Luddi96/BREmote-V2/Electronics/github_public/Rx/Rx_Nano/Rx_Nano_V2-1_BOM.xlsx

Comment | Designator | Footprint | JLCPCB Part #（optional）
1M | R22 | R0402
1N4148WS | D2,D5 | SODFL2512X90N | C2128
1k | R3,R38,R42 | R0402
1u | C5,C6,C12 | C0603
2.2uF | C11 | C0603
3k3 | R12 | R0402
5k1 | R5,R6 | R0402
LQW15AN6N8G00D | L_ANT1 | R0402 | C82919
10k | R4,R10,R11,R15,R20,R24,R28 | R0402
74HC4052PW 118 | IC6 | SOP65P640X110-16N | C19723807
100n | C1,C2,C4,C7,C8,C9,C10,C13,C16 | C0402
120k | R1 | R0603
AMS1117-3.3 | IC2 | SOT229P700X180-4N | C6186
AO3400A | Q3,Q4 | SOT95P280X125-3N | C20917
AW9523BTQR | IC1 | QFN50P400X400X80-25N | C148077
CH340K | AC1 | SOP100P600X180-11N | C968586
EL3H7_TA_-VG | IC4 | SOIC127P700X200-4N | C32565
MMBT5551 | T1 | SOT23-BEC | C2145
KT-0603R | LED3 | CHIP-LED0603 | C2286
P6SMB6.8CA | D4 | DIONM5436X261N | C78395
RFANT3216120A5T | R2 | R1206 | C127629
SM04B-SRSS-TB_LF__SN__P_ | J5 | SM04BSRSSTBLFSNP | C51940130 | alt C160404
SM06B-GHS-GB-TB_LF__SN_ | J2 | SM06BGHSGBTBLFSN | C51940119 | alt C51940119
SN74LV1T08DBVR(UMW) | IC7,IC8,IC9,IC10 | SOT-23-5 | C19100599
TYPE-C-31-M-12 | J1 | HRO_TYPE-C-31-M-12 | C165948
