Luddi96/BREmote-V2/Electronics/github_public/Rx/Rx_Nano/Rx_Nano_V2-1.pdf

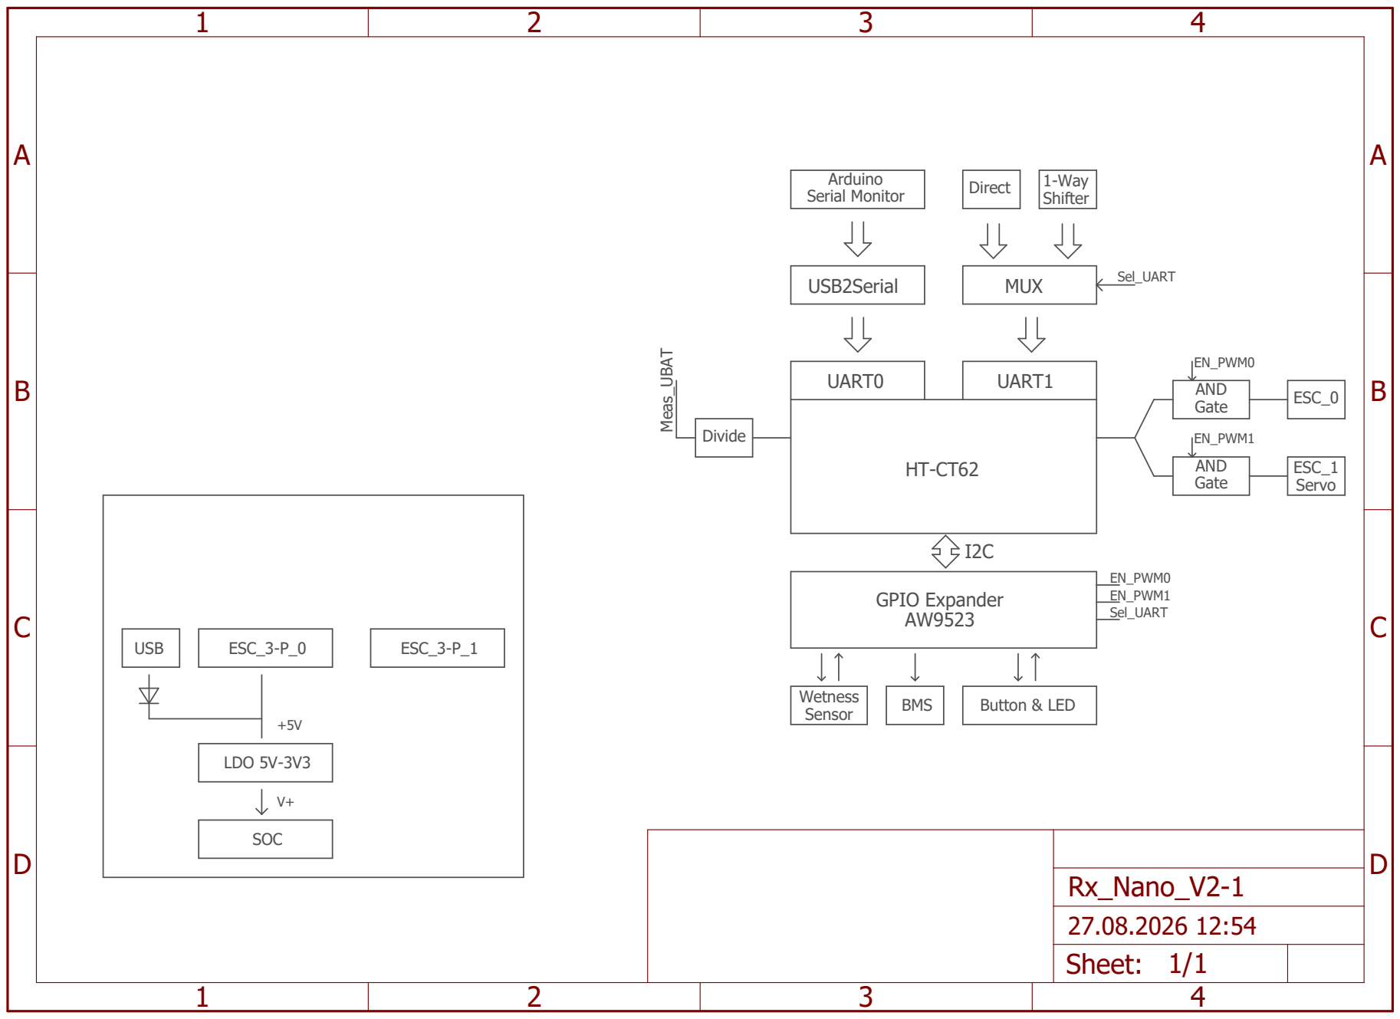
[picture p4: figure]
UART0; UART1; USB2Serial; MUX; Direct Arduino; Serial Monitor; 1-Way; Shifter; AND Gate; ESC_0; ESC_1 Servo; EN_PWM0; EN_PWM1; Sel_UART; Divide Meas_UBAT; GPIO Expander AW9523; Wetness; Sensor; BMS; Button & LED; EN_PWM0 EN_PWM1 Sel_UART; ESC_3-P_0; LDO 5V-3V3; ESC_3-P_1; SOC; USB; Sheet:; Rx_Nano_V2-1 27.08.2026 12:54 1/1

27.08.2026 12:55 f=1.45 C:\Users\rcb8fe\Desktop\Rx_Nano\Rx_Nano_V2-1.sch (Sheet: 1/1)

# V+ ⁺⁵V

# 1k GND

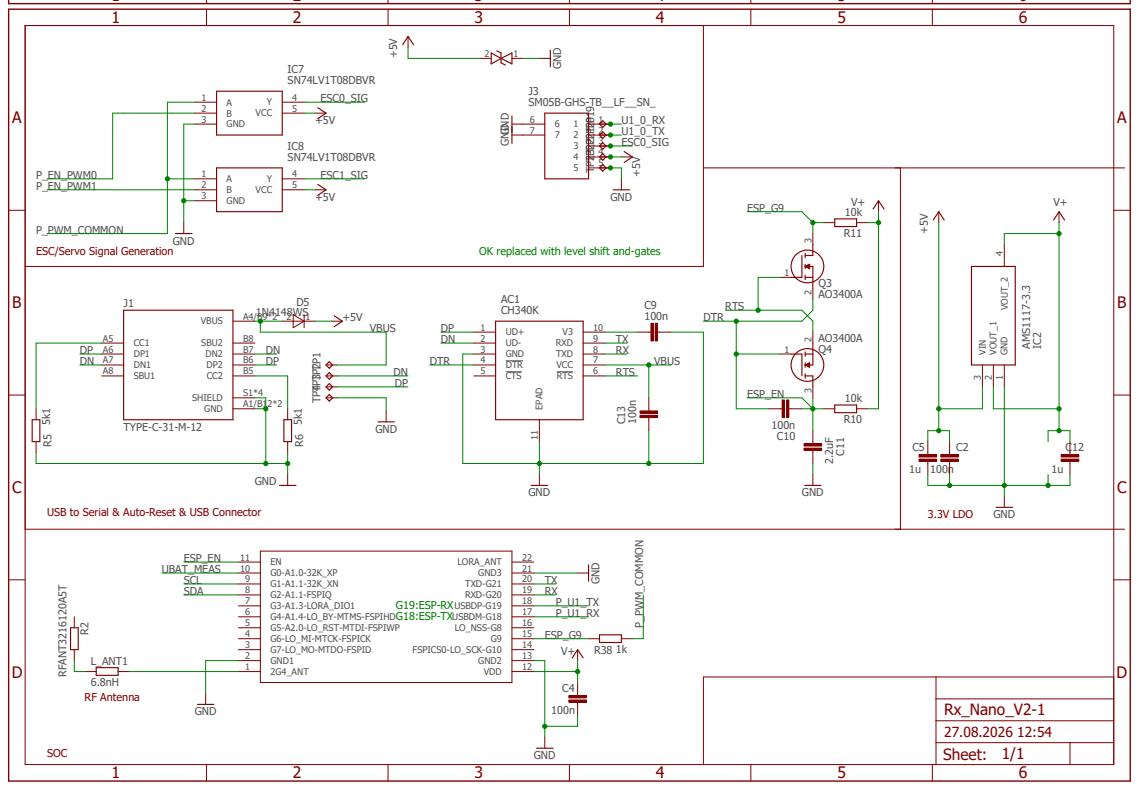
[picture p5: page 2]

ESC/Servo Signal Generation | | | IC7 SN74LV1T08DBVR

OK replaced with level shift and-gates

# GND ⁺⁵V

A

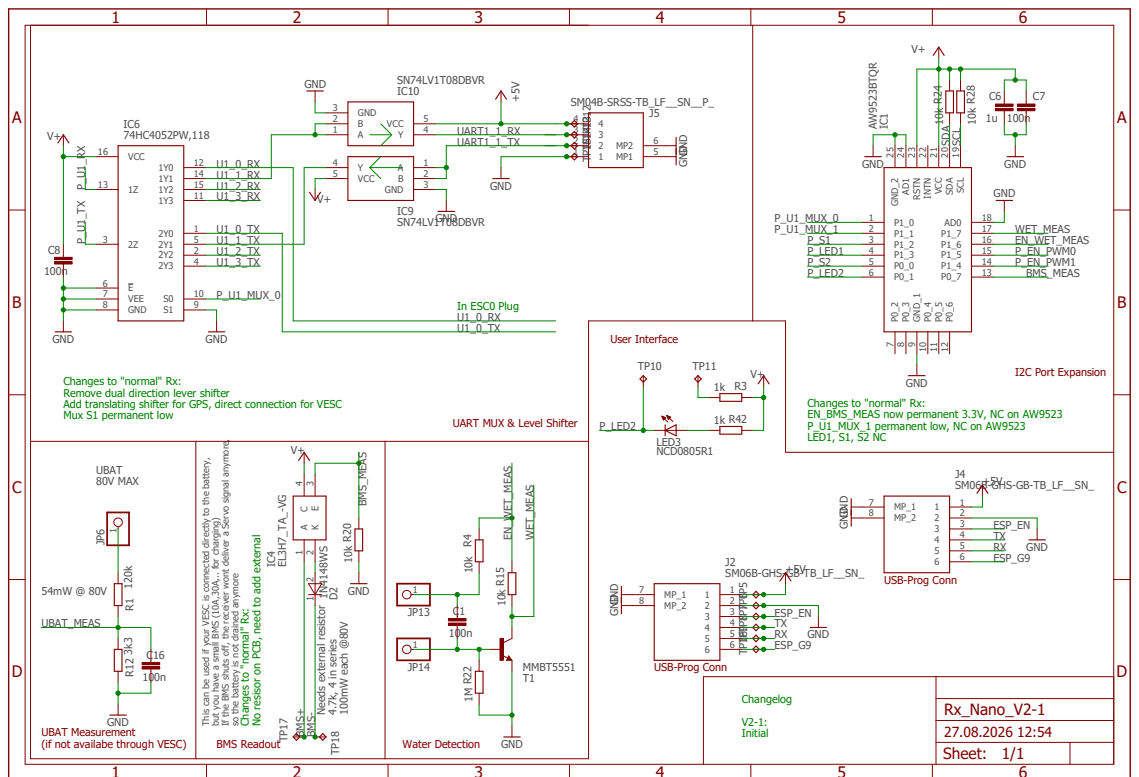
[picture p6: page 3]

SN74LV1T08DBVR GND

Changes to "normal" Rx:
Remove dual direction lever shifter
Add translating shifter for GPS, direct connection for VESC

EN_BMS_MEAS now permanent 3.3V, NC on AW9523
P_U1_MUX_1 permanent low, NC on AW9523
LED1, S1, S2 NC

UART MUX & Level Shifter

Changelog V2-1: Initial

Sheet: 1/1
