Luddi96/BREmote-V2/Electronics/github_public/Rx/Rx_Nano/Rx_Nano_V2-1.sch

## EAGLE design Electronics/github_public/Rx/Rx_Nano/Rx_Nano_V2-1.sch (2026-10-03)

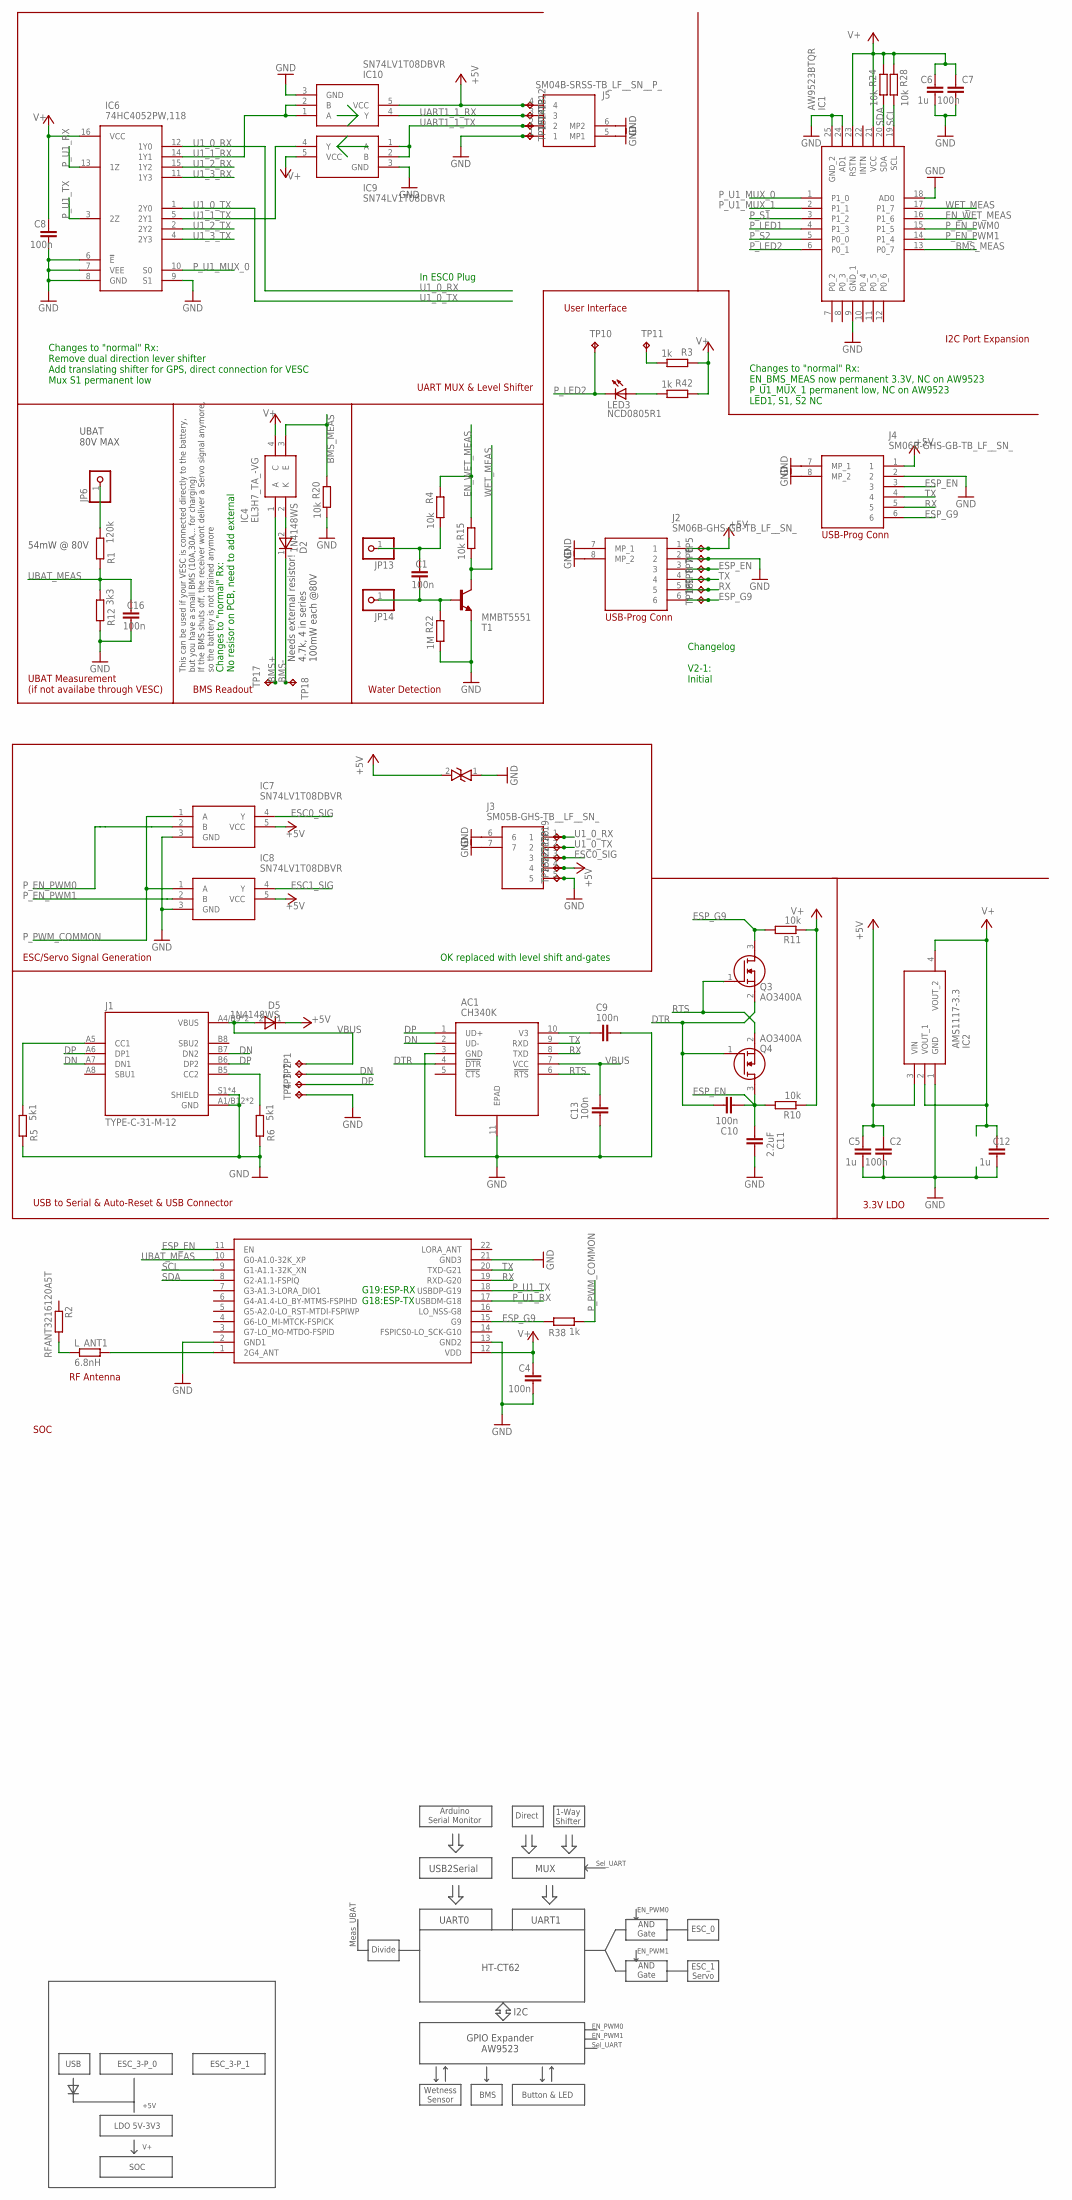
[picture p7: schematic Rx_Nano_V2-1.sch]

Parts:
AC1: CH340K; SOP100P600X180-11N
C1, C2, C4, C7, C8, C9, C10, C13, C16: 100n; C0402
C5, C6, C12: 1u; C0603
C11: 2.2uF; C0603
D2, D5: 1N4148WS; SODFL2512X90N
D4: P6SMB6.8CA; DIONM5436X261N
IC1: AW9523BTQR; QFN50P400X400X80-25N
IC2: AMS1117-3.3; SOT229P700X180-4N
IC4: EL3H7_TA_-VG; SOIC127P700X200-4N
IC6: 74HC4052PW,118; SOP65P640X110-16N
IC7, IC8, IC9, IC10: SN74LV1T08DBVR; SOT95P280X145-5N
J1: TYPE-C-31-M-12; HRO_TYPE-C-31-M-12
J2, J4: SM06B-GHS-GB-TB_LF__SN_; SM06BGHSGBTBLFSN
J3: SM05B-GHS-TB__LF__SN_; SM05BGHSTBLFSN
J5: SM04B-SRSS-TB_LF__SN__P_; SM04BSRSSTBLFSNP
JP6, JP13, JP14: PINHD-1X1; 1X01
LED3: NCD0805R1; CHIP-LED0603
L_ANT1: 6.8nH; R0402
Q3, Q4: AO3400A; SOT95P280X125-3N
R1: 120k; R0603
R2: RFANT3216120A5T; R1206
R3, R38, R42: 1k; R0402
R4, R10, R11, R15, R20, R24, R28: 10k; R0402
R5, R6: 5k1; R0402
R12: 3k3; R0402
R22: 1M; R0402
T1: MMBT5551; SOT23-BEC
TP1, TP2, TP3, TP4, TP5, TP6, TP7, TP8, TP9, TP10, TP11, TP12, TP13, TP14, TP15, TP16, TP17, TP18, TP19, TP20, TP21, TP22, TP23: TPB1,27; B1,27
U$5: HT-CT62

Connections:
+5V: C2.1, C5.1, D4.2, D5.1 (K), IC2.3 (VIN), IC7.5 (VCC), IC8.5 (VCC), IC10.5 (VCC), J2.1, J3.4, J4.1, J5.4, TP5.TP, TP12.TP, TP22.TP
BMS+: IC4.1 (A), TP17.TP
BMS-: D2.1 (K), TP18.TP
BMS_MEAS: IC1.13 (P0_7), IC4.3 (E), R20.1
DN: AC1.2 (UD-), J1.A7 (DN1), J1.B7 (DN2), TP2.TP
DP: AC1.1 (UD+), J1.A6 (DP1), J1.B6 (DP2), TP3.TP
DTR: AC1.4 (!DTR), C10.1, Q3.2 (S), Q4.1 (G)
EN_WET_MEAS: IC1.16 (P1_6), R4.1, R15.1
ESC0_SIG: IC7.4 (Y), J3.3, TP21.TP
ESC1_SIG: IC8.4 (Y)
ESP_EN: C10.2, C11.2, J2.3, J4.3, Q4.3 (D), R10.2, TP7.TP, U$5.11 (EN)
ESP_G9: J2.6, J4.6, Q3.3 (D), R11.2, R38.1, TP16.TP, U$5.15 (G9)
GND: AC1.3 (GND), AC1.11 (EPAD), C2.2, C4.2, C5.2, C6.2, C7.2, C8.2, C9.1, C11.1, C12.2, C13.2, C16.2, D4.1, IC1.9 (GND_1), IC1.18 (AD0), IC1.24 (AD1), IC1.25 (GND_2), IC2.1 (GND), IC6.6 (!E), IC6.7 (VEE), IC6.8 (GND), IC6.9 (S1), IC7.3 (GND), IC8.3 (GND), IC9.3 (GND), IC10.3 (GND), J1.A1/B12 (GND), J1.S1 (SHIELD), J2.2, J2.7 (MP_1), J2.8 (MP_2), J3.5, J3.6, J3.7, J4.2, J4.7 (MP_1), J4.8 (MP_2), J5.1, J5.5 (MP1), J5.6 (MP2), R5.1, R6.1, R12.1, R20.2, R22.2, T1.E, TP4.TP, TP6.TP, TP15.TP, TP23.TP, U$5.2 (GND1), U$5.13 (GND2), U$5.21 (GND3)
unnamed: L_ANT1.2, R2.2
unnamed: J1.A5 (CC1), R5.2
unnamed: L_ANT1.1, U$5.1 (2G4_ANT)
unnamed: LED3.A, R42.2
unnamed: R3.2, TP11.TP
unnamed: J1.B5 (CC2), R6.2
unnamed: JP6.1, R1.2
unnamed: D2.2 (A), IC4.2 (K)
unnamed: C1.2, JP14.1, R22.1, T1.B
unnamed: C1.1, JP13.1, R4.2
unnamed: AC1.10 (V3), C9.2
P_EN_PWM0: IC1.15 (P1_5), IC7.2 (B)
P_EN_PWM1: IC1.14 (P1_4), IC8.2 (B)
P_LED1: IC1.4 (P1_3)
P_LED2: IC1.6 (P0_1), LED3.C, TP10.TP
P_PWM_COMMON: IC7.1 (A), IC8.1 (A), R38.2
P_S1: IC1.3 (P1_2)
P_S2: IC1.5 (P0_0)
P_U1_MUX_0: IC1.1 (P1_0), IC6.10 (S0)
P_U1_MUX_1: IC1.2 (P1_1)
P_U1_RX: IC6.13 (1Z), U$5.17 (USBDM-G18)
P_U1_TX: IC6.3 (2Z), U$5.18 (USBDP-G19)
RTS: AC1.6 (!RTS), Q3.1 (G), Q4.2 (S)
RX: AC1.8 (TXD), J2.5, J4.5, TP9.TP, U$5.19 (RXD-G20)
SCL: IC1.19 (SCL), R28.2, U$5.9 (G1-A1.1-32K_XN)
SDA: IC1.20 (SDA), R24.2, U$5.8 (G2-A1.1-FSPIQ)
TX: AC1.9 (RXD), J2.4, J4.4, TP8.TP, U$5.20 (TXD-G21)
U1_0_RX: IC6.12 (1Y0), J3.1, TP19.TP
U1_0_TX: IC6.1 (2Y0), J3.2, TP20.TP
U1_1_RX: IC6.14 (1Y1), IC10.1 (A), IC10.2 (B)
U1_1_TX: IC6.5 (2Y1), IC9.4 (Y)
U1_2_RX: IC6.15 (1Y2)
U1_2_TX: IC6.2 (2Y2)
U1_3_RX: IC6.11 (1Y3)
U1_3_TX: IC6.4 (2Y3)
UART1_1_RX: IC10.4 (Y), J5.3, TP13.TP
UART1_1_TX: IC9.1 (A), IC9.2 (B), J5.2, TP14.TP
UBAT_MEAS: C16.1, R1.1, R12.2, U$5.10 (G0-A1.0-32K_XP)
V+: C4.1, C6.1, C7.1, C8.1, C12.1, IC1.21 (VCC), IC1.23 (RSTN), IC2.2 (VOUT_1), IC2.4 (VOUT_2), IC4.4 (C), IC6.16 (VCC), IC9.5 (VCC), R3.1, R10.1, R11.1, R24.1, R28.1, R42.1, U$5.12 (VDD)
VBUS: AC1.7 (VCC), C13.1, D5.2 (A), J1.A4/B9 (VBUS), TP1.TP
WET_MEAS: IC1.17 (P1_7), R15.2, T1.C

Notes on the sheet:
RF Antenna
USB to Serial & Auto-Reset & USB Connector
UBAT 80V MAX
54mW @ 80V
UBAT Measurement (if not availabe through VESC)
Water Detection
BMS Readout
Needs external resistor! 4.7k, 4 in series 100mW each @80V
This can be used if your VESC is connected directly to the battery, but you have a small BMS (10A,30A,.. for charging) If the BMS shuts off, the receiver wont deliver a Servo signal anymore, so the battery is not drained anymore
3.3V LDO
HT-CT62
UART0
UART1
USB2Serial
MUX
Direct
Arduino Serial Monitor
1-Way Shifter
AND Gate
ESC_0
ESC_1 Servo
EN_PWM0
EN_PWM1
Sel_UART
Divide
Meas_UBAT
GPIO Expander AW9523
I2C
Wetness Sensor
BMS
Button & LED
ESC_3-P_0
LDO 5V-3V3
ESC_3-P_1
SOC
USB
+5V
ESC/Servo Signal Generation
UART MUX & Level Shifter
User Interface
I2C Port Expansion
Changelog V2-1: Initial
Changes to "normal" Rx: EN_BMS_MEAS now permanent 3.3V, NC on AW9523 P_U1_MUX_1 permanent low, NC on AW9523 LED1, S1, S2 NC
In ESC0 Plug
OK replaced with level shift and-gates
G19:ESP-RX G18:ESP-TX
Changes to "normal" Rx: Remove dual direction lever shifter Add translating shifter for GPS, direct connection for VESC Mux S1 permanent low
Changes to "normal" Rx: No resisor on PCB, need to add external
USB-Prog Conn
