Luddi96/BREmote-V2/(commit log)

2026-08-29 Add WiFi config and VESC bridge to Rx
2026-09-22 Logger dbit fix, add Rx binaries
    [GPS.ino, Logger.ino, VESC.ino]
2026-10-03 Add Rx Nano PCB files
    [Rx_Nano_V2-1.sch, Rx_Nano_V2-1_BOM.xlsx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]
